Rxmsey/Arduino-Quadcopter-Drone-/README.md

<h1>About this project </h1>

This is an auto-leveling **Arduino Uno based quadcopter drone** that is easy to build and fun to fly. Auto leveling means that, when you release the sticks the quadcopter levels itself.

The total cost to build a quadcopter like this is approximately $150 if you use the hardware list below. This includes a battery, transmitter, charger, etc.

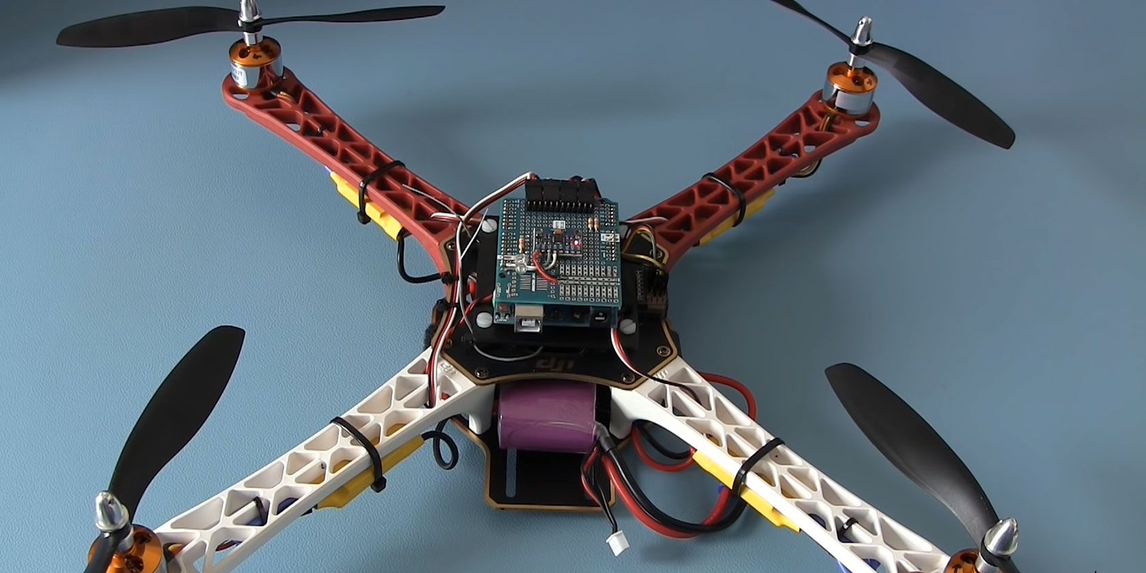
[picture p1: auto-levelling-quadcopter-with-arduino.jpg]
Drone


The purpose of it is to provide a simple and understandable code that is needed to build an Arduino based auto-level quadcopter flight controller.

The code is well commented and clearly explained

<h1> Steps </h1>

1. Dowload This [Project](https://codeload.github.com/Rxmsey/Arduino-Quadcopter-Drone-/zip/refs/heads/main)

2. Download [Arduino IDE](https://downloads.arduino.cc/arduino-nightly-windows.zip)

3. Read the explanation within the [Building step by step.txt](https://github.com/Rxmsey/Arduino-Quadcopter-Drone-/blob/main/Building%20step%20by%20step.txt) file

<h1> Terms of use </h1>

THE SOFTWARE IS PROVIDED "AS IS", WITHOUT WARRANTY OF ANY KIND, EXPRESS OR
IMPLIED, INCLUDING BUT NOT LIMITED TO THE WARRANTIES OF MERCHANTABILITY,
FITNESS FOR A PARTICULAR PURPOSE AND NONINFRINGEMENT. IN NO EVENT SHALL THE
AUTHORS OR COPYRIGHT HOLDERS BE LIABLE FOR ANY CLAIM, DAMAGES OR OTHER
LIABILITY, WHETHER IN AN ACTION OF CONTRACT, TORT OR OTHERWISE, ARISING FROM,
OUT OF OR IN CONNECTION WITH THE SOFTWARE OR THE USE OR OTHER DEALINGS IN
THE SOFTWARE.

<h1> Safety note </h1>

Always remove the propellers and stay away from the motors when you're working on the software unless you 
are 100% certain of what you are doing or finished setting up.
