Rxmsey/Arduino-Quadcopter-Drone-/schematic .png

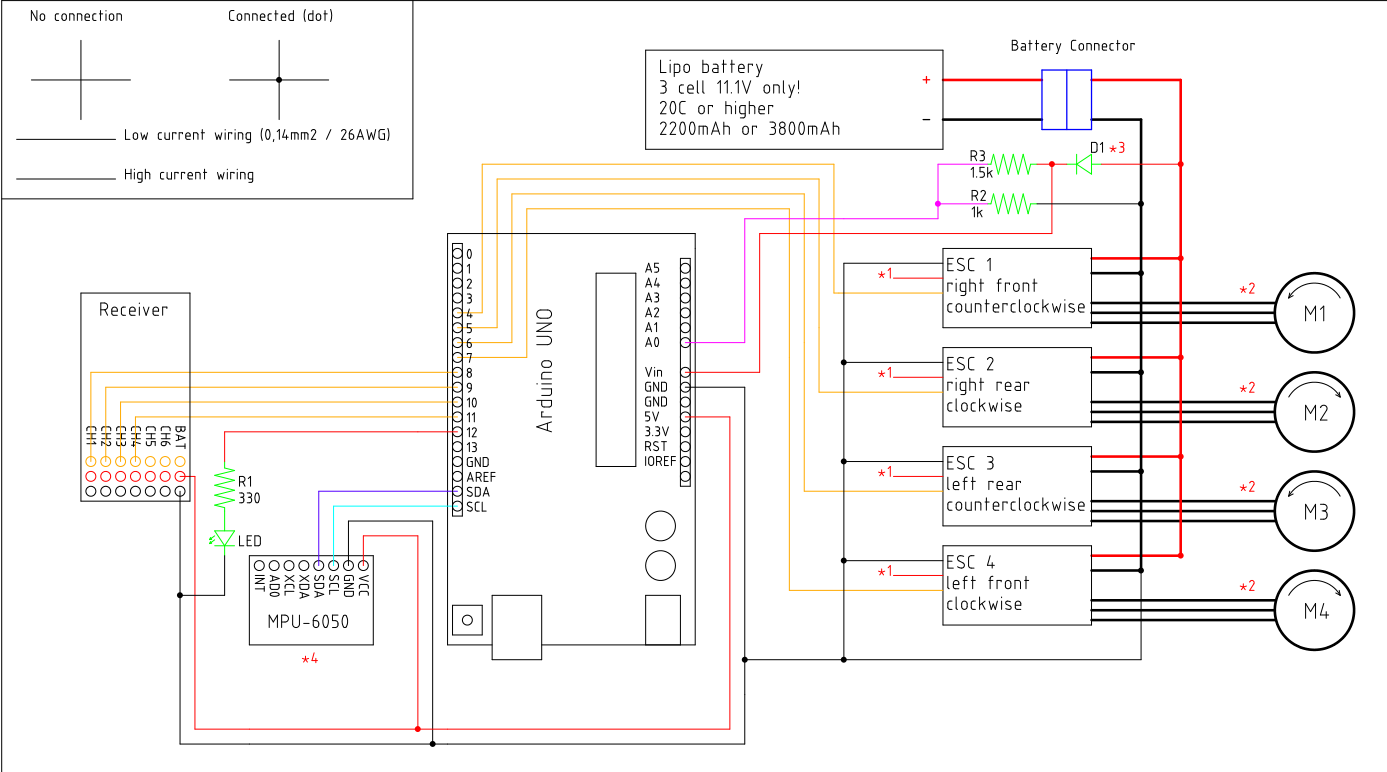
schematic .png
