Rxmsey/Arduino-Quadcopter-Drone-/Parts/Parts Images/arduino.jpg

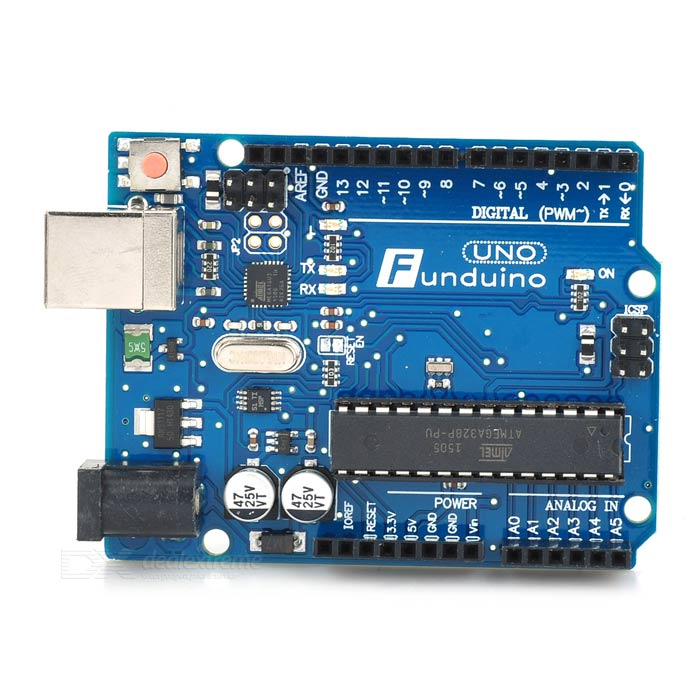
Parts/Parts Images/arduino.jpg
