Rxmsey/Arduino-Quadcopter-Drone-/Parts/Parts Images/battery.jpg

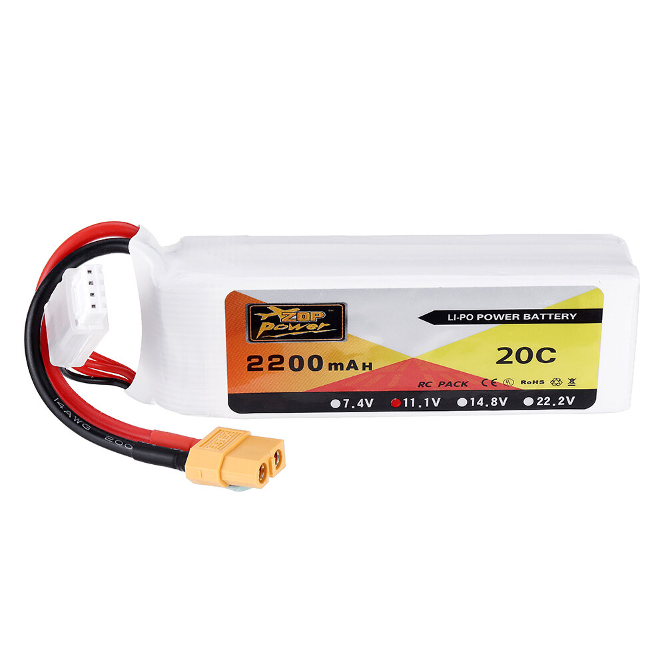
Parts/Parts Images/battery.jpg
