Rxmsey/Arduino-Quadcopter-Drone-/Parts/Parts Images/charger.jpg

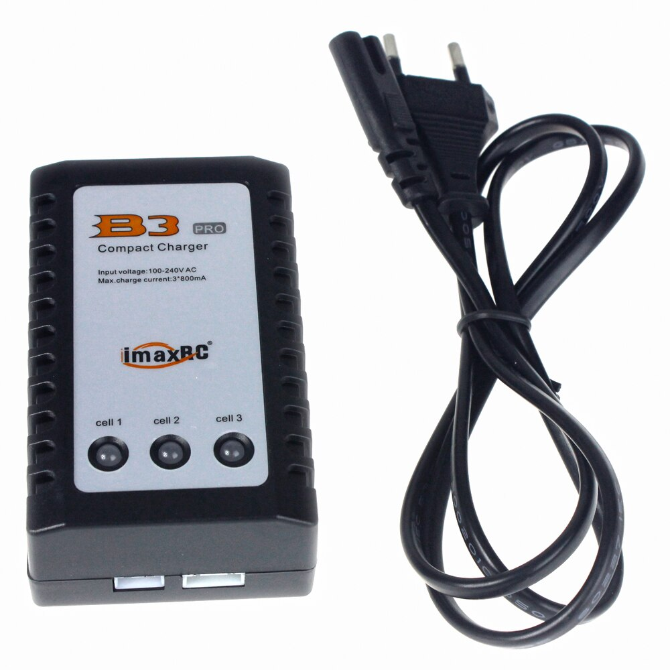
Parts/Parts Images/charger.jpg
