Rxmsey/Arduino-Quadcopter-Drone-/Parts/Parts Images/Frames.jpg

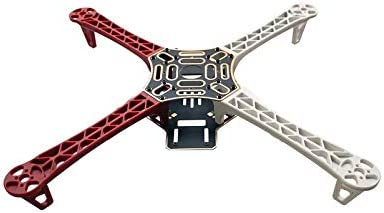
Parts/Parts Images/Frames.jpg
