Rxmsey/Arduino-Quadcopter-Drone-/Parts/Parts Images/motor-props-esc-combo.jpg

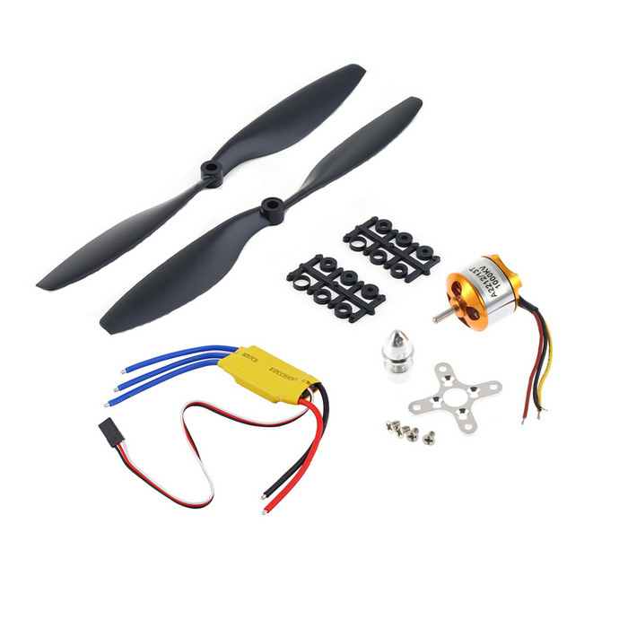
Parts/Parts Images/motor-props-esc-combo.jpg
