Rxmsey/Arduino-Quadcopter-Drone-/Parts/Parts Images/mpu6050.jpg

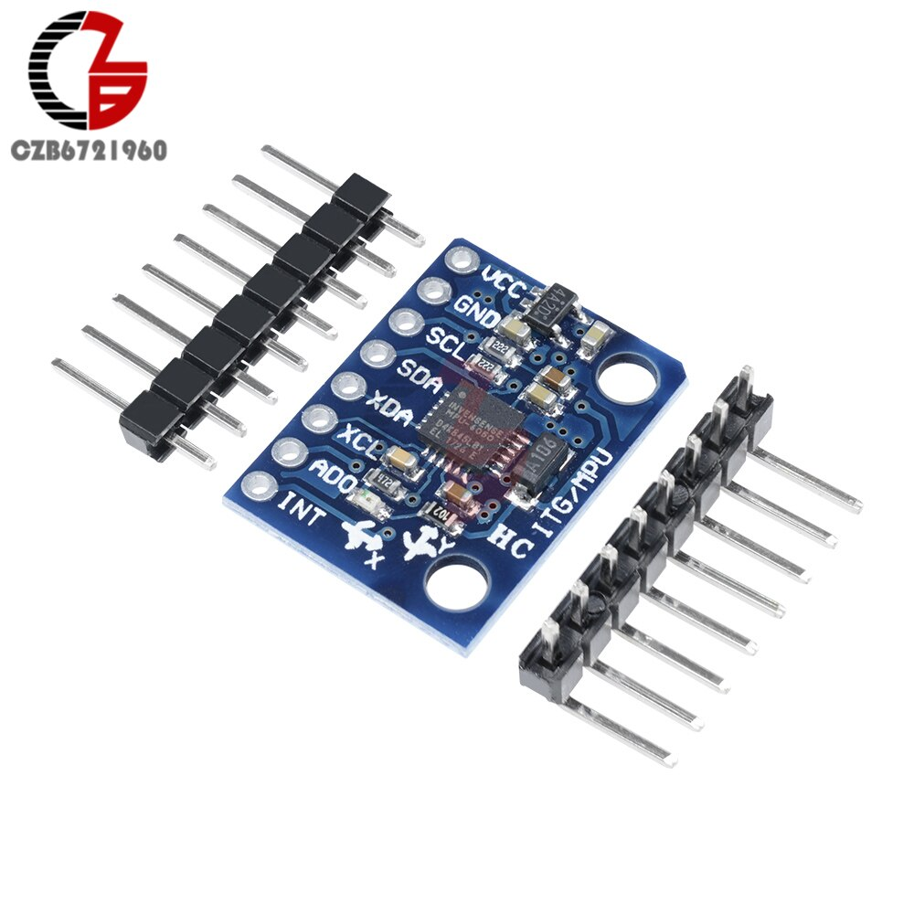
Parts/Parts Images/mpu6050.jpg
