Rxmsey/Arduino-Quadcopter-Drone-/Parts/Parts Images/transmitter and receiver.jpg

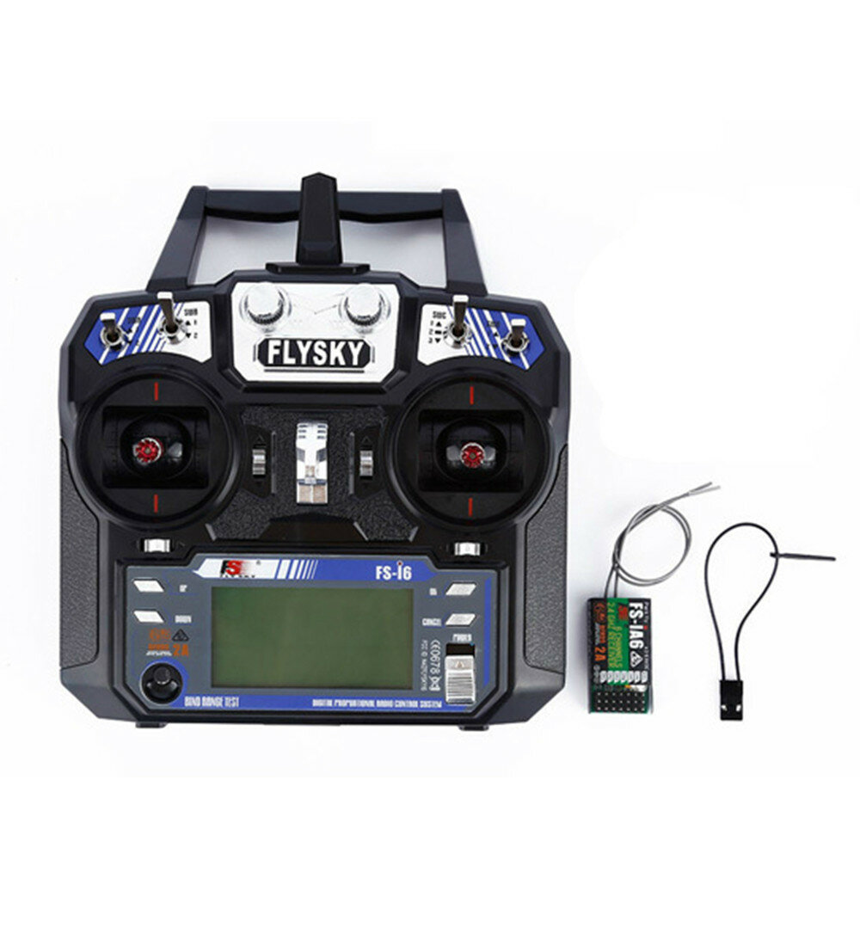
Parts/Parts Images/transmitter and receiver.jpg
