Rxmsey/Arduino-Quadcopter-Drone-/(threads)

Thread 1 (2023-06-17):

Setup.ino problem

Namitjainx, 2023-06-17:
The setup code stops at line 196 that says "move stick "nose up" and back to center to continue". It skips through the starting questions and jumps straight to line 165 saying "gently move.....extends". I am using an Arduino nano which is the problem I guess because it worked okay with an Arduino uno

idiosyncretic, 2024-06-19:
only been tested on UNO.
